Flopsey/splitflap/(list of files, cad)

Other CAD files:
3d/global_constants.scad
3d/color_util.scad
3d/flap.scad
3d/flap_fonts.scad
3d/font_generator.scad
3d/projection_renderer.scad
3d/sensor_pcb_dimensions.scad
3d/shapes.scad
3d/spool.scad
3d/tools/classic_pcb_mount.scad
3d/tools/mounting_bracket.scad
3d/tools/sensor_pcb_case.scad
