Flopsey/splitflap/(commit log)

2021-08-31 Adapt project to personal needs
    [splitflap.scad]
2022-02-16 Revert "Adapt project to personal needs"
    This reverts commit 6eba349816f6e669107014161d65255342b0caa6.
    [splitflap.scad]
2022-02-16 Improve 3d laser artifact generation (#158)
    - Add 4x panelized output generation
    - Generate text files that describe the dimensions of each SVG file (for verifying SVG processors - e.g. Ponoko - are handling dimensions correctly)
    - Add Elecrow wood kerf preset and zipped PDF generation: no etching, black lines, labeled dimensions, no optimization
    Example output pdf: [elecrow.pdf](https://github.com/scottbez1/splitflap/files/6751491/elecrow.pdf)
2022-02-16 3d: refactor flap+letter rendering; update 3d model and font generation (#154)
    Implements a variety of changes to flap and font rendering, ultimately as part of the development of screen-printing jigs and artifacts.
    - Extract common flap + letter rendering to a single definitive flap.scad file with easy-to-use flap modules that handle front/back and top/bottom-half-letter logic
    - Update splitflap.scad to use the refactored flap module, which results in an alternative implementation of #113 with simplified logic and code shared with font renderer
    - Update font_generator.scad to use the refactored flap module, and change layout and implementation of double-sided output (flaps are all faci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
    [color_util.scad, flap.scad, flap_fonts.scad, font_generator.scad, global_constants.scad, projection_renderer.scad, splitflap.scad]
2022-02-16 Mounting Brackets (#160)
    Creates `mounting_bracket.scad` which generates geometry for 3D-printable mounting brackets. Two brackets are defined, using the same common base geometry:
    * `mounting_bracket_t_slot` for mounting a module to an M4-sized T-slot, using an M4-12 bolt and matching T-nut.
    * `mounting_bracket_screw_holes` for mounting a module to a wooden board using flat-head M4 screws. The hole for the enclosure's bolt either needs to be undersized for thread engagement or enlarged for a heat-set insert (user's choice).
    The base geometry uses the existing hole in the bottom enclosure piece and juts up against the left and right enclosure sides to prevent the module from twisting.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
    [mounting_bracket.scad, shapes.scad, splitflap.scad]
2022-02-16 Center front face, tabs, and bolts relative to the window (#159)
    Previously the front face and tabs were all centered between the left and right walls, but this resulted in features looking oddly off-center when viewed from the front (where the walls aren't visible and the only other visible feature is the window).
    This changes the tabs and front face positioning so that everything is centered relative to the front window. The tabs are made slightly smaller, and the top/bottom pieces are no longer horizontally symmetric as a result. This is not a breaking change (overall dimensions are all the same), but this could not be placed to the _right_ of older modules since the front face has shift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
    [splitflap.scad]
2022-02-16 Tool/model for laying out a merged front panel (#165)
    `combined_front_panel.scad` is a model for a configurable merged front panel. The frame width/height are configurable, as are the number of rows & columns of modules and the spacing between modules (can be defined as a "gap" value beyond the minimum possible module spacing, or a center-to-center distance).
    There is a matching python script `generate_combined_front_panel.py` for exporting the design as an SVG, for use with a laser cutter or CAM tool.
    Also adds some minimal support for routers/endmills with non-trivial kerf - only for the tabs on the front panel - which adds the option of dog bones for the corners and allows for using a t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
    [combined_front_panel.scad, splitflap.scad]
2022-02-16 Classic Driver PCB Mount (#166)
    This is a 3D printable mounting bracket for the "classic" driver PCB. It includes three mounting points for the PCB itself using heat-set inserts, and two screw mounts on either side for securing into a board.
    ![sf-classic-pcb-mount](https://user-images.githubusercontent.com/24282108/125182112-38add000-e1d9-11eb-9607-914a2b4d920a.png)
    In addition to the mount itself this PR makes some quality of life changes to some of the `shapes` functions, including conditional rounding of corners for both the 2D and 3D rounded square functions. I also added the capability to create an "additive" 3D fillet for the rounded square function, seen here connecting the PCB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
    [classic_pcb_mount.scad, sensor_pcb_case.scad, shapes.scad]
2022-02-16 Add $fn parameter to have smoother edges when generating svg fonts (#168)
    At the current state, when you use the `generate_font.py` file, the generated svgs are quite low poly. This is due to the facet number on `facet.scad` is set 0 as default.
    If we look at the image below, the first one is what you would get if you generated the fonts. I tried 60, but it's not quite smooth enough. So I just doubled the value and tried 120. 120 gave me cleaner and more refined results.
    But the [docs ](https://en.wikibooks.org/wiki/OpenSCAD_User_Manual/Other_Language_Features#.24fa.2C_.24fs_and_.24fn) don't recommend going beyond 100, so this pull request is using 100.
    ![difference_resolution](ht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
    [flap.scad]
2022-02-16 Add a lot more rendering/design options for generate_2d.py (#170)
    New options:
    ```
    --no-alignment-bar Do not include features for the alignment bar
    --no-front-panel Do not include the front face of the enclosure, e.g. if you will use
    generate_combined_front_panel.py instead.
    --no-mounting-holes Do not include mounting hole on top/bottom enclosure pieces.
    --no-connectors Do not include inter-module connector pieces.
    --no-sensor-jig Do not include the sensor spacing jig.
    --no-source-info Do not include the source info: revision, date, url.
    --zip-tie {NONE,STANDARD,UPDOWN}
    Where to place zip-tie holes for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
    [pcb.scad, splitflap.scad, spool.scad]
2022-02-16 Front panel generation improvements (#173)
    - Add `--center-window` option to vertically center the modules based on their window, rather than the default of centering based on flap/letter centers
    - Improve export performance drastically by omitting the 3d splitflap modules entire in projection rendering mode
    - Fix `--center-center-x` and `--center-center-y` arguments
    - Change dog bone shape (and front face M4 hole) to rectangles to simplify the 2d geometry that's exported for external CAM (Fusion 360 did not perform well with all of the polygon-ized cricles)
    [combined_front_panel.scad, splitflap.scad]
2022-02-16 Tweak fit parameters; add Elecrow acrylic kerf value (#175)
    - increase clearance for PCB connector pins (slot width)
    - remove spool tab interference (kerf value isn't accurate enough anyway, and undersizing requires labor-intensive filing/sanding whereas oversizing just requires a little glue)
    - shrink spool axle M4 hole to get less spool "sag" due to unnecessary clearance
    - decrease interference on magnet hole (again, an undersized hole is labor intensive to fix whereas oversized just requires a dot of glue in the worst case)
    - add Elecrow acrylic kerf value that has been tested
    [sensor_pcb_dimensions.scad, splitflap.scad]
2022-02-16 Log some useful values when generating combined front panels (#176)
    - Add support for printing debug values from OpenSCAD as part of the projection-renderer process
    - Print the calculated X and Y gaps between modules
    - Print the top and bottom frame margins (distance between top/bottom of module and edge of frame)
    [combined_front_panel.scad]
2022-02-16 Fix combined front panel gap x/y handling
    [combined_front_panel.scad]
2022-02-16 Add side-by-side option for rendering font/flap designs (#186)
    [font_generator.scad]
